mxmxmx/temps_utile-/(threads)

Thread 3 (2016-09-14):

New Arduino IDE (> 1.6.9) breaks TU compile

jeremybernstein, 2016-09-14:
Arduino made a change to the IDE which restricts automatic compilation of resources in subfolders (https://github.com/arduino/arduino-builder/pull/148) which breaks this project (linkage errors). You may need to explicitly #include the cpp files (ugly) or simply move the files to the top-level or a src/ folder.

mxmxmx, 2016-09-14:
brilliant (and thanks for the heads-up).

does this work?
https://github.com/mxmxmx/temps_utile-/tree/fix_6_11

jeremybernstein, 2016-09-14:
Yes it does.

mxmxmx, 2016-09-14:
ok, cool. it doesn't seem to break backwards compatibility either.

Closed 2016-09-14.

Thread 4 (2016-10-08):

Left Encoder button press sync not working

okyeron, 2016-10-08:
I did some poking around in APP_CLK.ino tonight and ran a quick test.

Left-encoder-button press Sync works OK if I make the following modifications:

```
void sync() {
    clk_cnt_ = 0x0;
    div_cnt_ = 0x0;
    ticks_ = 0x0;
  }
```

```
void CLOCKS_leftButton() {

  Clock_channel &selected = clock_channel[clocks_state.selected_channel];

  // sync:
  for (int i = 0; i < NUM_CHANNELS; ++i)
        clock_channel[i].sync();

  if (selected.get_page() == TEMPO) {
    selected.set_page(PARAMETERS);
    clocks_state.cursor = clocks_state.cursor_state;
    selected.update_enabled_settings(clocks_state.selected_channel);
    clocks_state.cursor.AdjustEnd(selected.num_enabled_settings() - 1);
    return;
  }
}

```

Previously it looked like ticks_ was not being reset in the sync() function. I'm not sure that's the right place to reset ticks_ in this case.
And then in CLOCKS_leftButton() it would not sync if you had the TEMPO page loaded. (because returned before sync() was called?)

I need to learn how to use Github properly - hope this works OK for the moment.

okyeron, 2017-01-10:
Code update on Jan 9, 2017 looks to have fixed this.

mxmxmx, 2017-01-10:
yeah, it should have the same effect. zeroing ticks_ in the sync() function would be just as fine, or slightly more straightforward. as for the leftbutton behaviour, i've commented out the menu stuff entirely, so the tempo display doesn't toggle when syncing the channels.

Closed 2017-01-10.

Thread 5 (2016-10-18):

Adding Swing?

okyeron, 2016-10-18:
I had the idea that being able to "swing" the beat for any Temps output would be a really neat feature. The idea being to delay all the even-numbered 16th notes within the beat (2, 4, 6, 8, etc.)

A friend helped me hack together some basic code for this, but we're not sure exactly how to implement it in the codebase so I thought I'd post it here to see if this is something useful.

I tried this around line 838 in the APP_CLK.ino file:
(below the brute force ugly sync hack)

`     // ATTEMPT AT SWING

```
// enc_value = .5;
// this would be a setting for swing amount from encoder input or settings
// some value between 0-1 where 50% is no swing, 66% being triplets

 uint32_t swing_val = 2*channel_frequency_in_ticks_ * enc_value;
 uint32_t frame_length_in_ticks = (clk_cnt_%2 == 0) ? (swing_val) : (2*channel_frequency_in_ticks_- swing_val);

 // time to output ?
 if (subticks_ >= frame_length_in_ticks && _sync) { // ckm: changed 'channel_frequency_in_ticks_' to 'frame_length_in_ticks'
```

`

We made a couple assumptions that clk_cnt_ was "one beat" and that shifting the value for channel_frequency_in_ticks_ would swing the beat output.

mxmxmx, 2017-08-01:
see here now (which adds phase offset, not swing)

https://github.com/mxmxmx/temps_utile-/tree/sync_variation

Closed 2017-08-01.

Thread 7 (2016-11-07):

Multiplys continue to pulse after trig is removed

okyeron, 2016-11-07:
Using both TR inputs. One channel set to "-" another set to 2x. If I remove the trig input on TR2 (pull the cable out of the jack) - that channel (which has a mult "2x") continues to send pulses.

Does not happen with "-" or divs "/x"

Also this seems to happen the other way where it's not sending pulses until you change something - haven't been able to replicate this yet.

mxmxmx, 2016-11-07:
hey,

that's because there's no way knowing the jack has been removed. in theory, some sort of detection mechanism could have been implemented (in parts, in hardware), but i didn't. so when multiplying/running off the internal timer, the module keeps on multiplying; cf 4ms SCM, same thing.

mxmxmx, 2016-11-08:
sure. and sort of, one could do it in software only. ie something like this: if the input trigger frequency increased by this or that amount relative to the previous frequency = someone removed the cable. you'd still get a bunch of triggers at the old frequency. the issue is that in multiplication mode the external clock signals are used to determine the overflow value of an internal timer, they don't actually trigger something; ie it's the last and second-to-last clock that determine the output frequency at any given moment, so when you plug the cable, the timer will sit there.

okyeron, 2016-11-08:
Ah... I see. Great explanation.

Closed 2016-11-07.

Thread 29 (2017-09-15):

Bug that seems to have disappeared... therfore hard to reproduce!

markfrancombe, 2017-09-15:
Hi,
Self built module, immediately after first turn on (therefore suspecting build error) seemed to crash (screen went blank operation stopped in the following situation.
1) audio modules connected to both 1 and 2 outs
2) ch 1 clock source changed to INT for testing Module 1 starts... played with mult/div.. all working as it should
3) went into ch 2 and set clock source to INT, no operation occured... pressed up button, unit crashed.

This situation was completely reproducible every time, every power cycle, UNTIL...
I read the manual and learned about the up button/long press, to get to BPM counter (was wondering about that actually, when I was testing the ch1. ("wheres the f...ing BPM?" I muttered)

However performing this combo, seems to have fixed the issue, tried power cycling even with no setting save and it now does NOT crash and seems to work 100%

Lovely module... fun so far!

mxmxmx, 2019-02-12:
ok, closing this ... (hopefully it didn't reappear!)

Closed 2019-02-12.

Thread 30 (2017-10-05):

Clock source setting do not save

GitBruno, 2017-10-05:
I expected `Clock source` setting to be included in save. (Running 1.2.2 beta)

Is everything saved or are some elements excluded?

Notes:
    I don't see the "saving ....." message, just the growing square
    However clock multiplications did  seem to save correctly
    Switching global trigger on/off does not seem to matter

Banshee700, 2018-01-14:
Yep, i mentioned that as well to Max

Closed 2018-02-23.

Thread 31 (2017-10-13):

clock doesn't start

evancorylevine, 2017-10-13:
I have an issue wherein the clock doesn't start on channel one unless I change the clock source and then change it back again. I am in MULT mode with the PW at 50% and div at /48. I saved this state, but whenever I restart the power the clock source has to be changed and then changed back to TR1 for the clock to begin on this channel. My second channel just starts when I power up. It doesn't need attention.

GitBruno, 2018-09-04:
There must be something wrong with your hardware build. Did you solve this?

mxmxmx, 2019-02-10:
temporary fix here now https://github.com/mxmxmx/temps_utile-/tree/1.3b

Closed 2019-02-10.

Thread 40 (2018-09-23):

external clock different threshold?

thomasvanta, 2018-09-23:
Hi,
I'd like to use my temps with the LZX video system (0-1V range).
This voltage won't trigger the clock input. There's adapters like the lzx bridge or the cadet, but I was wondering if a 'clock-in threshold' would be an easy parameter to implement in the general settings or if its tight to hardware.
:)

mxmxmx, 2018-09-23:
hi,

the threshold (~ 2.8V) is a hardware thing, try removing the two 33k resistors at the TR inputs (ie the voltage dividers before the NPNs)

Closed 2018-09-23.

Thread 47 (2019-03-07):

Inconsistent offset in mult/divide

joodi3k, 2019-03-07:
A channel's behavior is inconsistent when adding offset to divide. I've tested it with no global divide and under 48ppqn. Please see the attached videos as the behavior is so erratic that it defies easy description.

The first video is with no global divide, clock is being provided by a metropolis.
The second is the same but I'm adjusting offset on channel one instead of two.
The third is with 48ppqn being provided by a beat step pro.

https://www.dropbox.com/s/hysvjxpbmwnbui0/IMG_2467.MOV?dl=0

https://www.dropbox.com/s/menuacn9d1vdb5w/IMG_2478.MOV?dl=0

https://www.dropbox.com/s/jzkq2lrqfmxez9w/IMG_2479.MOV?dl=0

In all three cases the metropolis is providing reset every 4 bars.

mxmxmx, 2019-03-07:
so in the absence of easy description, i'm assuming you're saying that:

1. this issue is about the latest firmware version, 1.3beta: https://github.com/mxmxmx/temps_utile-/tree/1.3b

2. i'll be able to reproduce a/the problem simply by doing the following:
    - set divisor to some value > 1
    - set phase parameter to some value > 0

3. the reset stuff has nothing to do with it?

joodi3k, 2019-03-07:
Actually I’m on v1.2.3. I’ll update and see. My understanding of 1.3b was that it does address divider issues, but not the one I’m experiencing.

To your second item, maybe. Some offset values appear to work. Others change the divisor. Some seem to be the incorrect offset. And still others cause the channel to freeze. None of these inconsistencies are terribly “consistent” in that they don’t seem to always come into play at particular offsets. Except at 50%. That seems to always lock up. Even resyncing the TU doesn’t help.

Reset has nothing to do with it in that the reset does not appear to fix any of the errant behavior. Which is to say if reset caused everything to work as intended again, I’d be fine.

While we’re on the subject, I see a couple of other wrong-seeming behaviors in my 1u TU. In LFSR mode, probability doesn’t change the chance of bits flipping unless I have taps established. And even then it’s kind of hard to tell. Haven’t delved into this further because I keep running into the divider issue.

Also, the save and load behavior does not reflect what’s in the manual. I appear to only have one save slot that loads on power up. Which is really all I need, but now that we’re in the weeds it does seem worth noting.

Thanks

Sent from my iPhone

On Mar 6, 2019, at 11:53 PM, mxmxmx <notifications@github.com<mailto:notifications@github.com>> wrote:

so in the absence of easy description, i'm assuming you're saying that:

  1.  this issue is about the latest firmware version, 1.3beta: https://github.com/mxmxmx/temps_utile-/tree/1.3b

  2.  i'll be able to reproduce a/the problem simply by doing the following:

     *   set divisor to some value > 1
     *   set phase parameter to some value > 0
  3.  the reset stuff has nothing to do with it?

—
You are receiving this because you authored the thread.
Reply to this email directly, view it on GitHub<https://github.com/mxmxmx/temps_utile-/issues/47#issuecomment-470395411>, or mute the thread<https://github.com/notifications/unsubscribe-auth/AuEIznCUwKoGYUHwiqSyF5DsmaAlEKInks5vUKlXgaJpZM4biJlj>.

joodi3k, 2019-03-08:
Duh. Latest firmware seems to have cleared up the clock issue, at least with basic testing of the 50% offset. Load/save menu looks correct now. Not sure which version Shay at Plumb loaded mine with when he built it. Or if it just was borked when it got flashed. Thanks for the help.

On Mar 6, 2019, at 11:53 PM, mxmxmx <notifications@github.com<mailto:notifications@github.com>> wrote:

so in the absence of easy description, i'm assuming you're saying that:

  1.  this issue is about the latest firmware version, 1.3beta: https://github.com/mxmxmx/temps_utile-/tree/1.3b

  2.  i'll be able to reproduce a/the problem simply by doing the following:

     *   set divisor to some value > 1
     *   set phase parameter to some value > 0
  3.  the reset stuff has nothing to do with it?

—
You are receiving this because you authored the thread.
Reply to this email directly, view it on GitHub<https://github.com/mxmxmx/temps_utile-/issues/47#issuecomment-470395411>, or mute the thread<https://github.com/notifications/unsubscribe-auth/AuEIznCUwKoGYUHwiqSyF5DsmaAlEKInks5vUKlXgaJpZM4biJlj>.

Jay Reynolds
Tour Manager
Asleep At The Wheel
513-348-7712
jreynolds.bluesky@gmail.com<mailto:jreynolds.bluesky@gmail.com>

mxmxmx, 2019-03-09:
ok, let me know if/when i can close this issue.

re manual: that was updated to reflect v1.3, so you wouldn't have seen the new load/save menu (with 4 slots, not just one)

joodi3k, 2019-03-09:
You can close it. Thanks again.

Sent from my iPhone

On Mar 9, 2019, at 7:28 AM, mxmxmx <notifications@github.com<mailto:notifications@github.com>> wrote:

ok, let me know if/when i can close this issue.

re manual: that was updated to reflect v1.3, so you wouldn't have seen the new load/save menu (with 4 slots, not just one)

—
You are receiving this because you authored the thread.
Reply to this email directly, view it on GitHub<https://github.com/mxmxmx/temps_utile-/issues/47#issuecomment-471176958>, or mute the thread<https://github.com/notifications/unsubscribe-auth/AuEIzmZ2knIC_oKjp0o4TsChyddRKe18ks5vU7bfgaJpZM4biJlj>.

mxmxmx, 2019-03-10:
perfect, thanks!

Closed 2019-03-10.

Thread 51 (2020-01-04):

Pulsewidth and Global division setting no longer saved in v1.3

7dials, 2020-01-04:
Hi, I recently tried updating to firmware version 1.3 but have had to revert to version 1.2.3 as I find the new version unusable due to the following issues.

- The pulsewidth set in each channel is no longer saved.
- The global division setting for input TR1 is no longer saved.

This meant I had to reapply these setting every time I turned my modular back on and while the idea of user slots is attractive these issues make the unit unusable in a live situation.

patrickdowling, 2020-04-25:
FWIW this came up in the thread on MW last week, I've put tentative fixes here: [fix/misc_fix](https://github.com/patrickdowling/temps_utile-/tree/fix/misc_fix)

It only later occurred to me to check the issues here.
That's based off master, I'm not really current on which branch might be more up to date.

SimonKunz, 2020-11-19:
@patrickdowling Thank you for publishing your fixes. Just one question: will your fixed version of the firmware keep my calibration settings on the t_u when I install it like described [here](https://github.com/mxmxmx/temps_utile-/wiki/firmware#compile-the-firmware-yourself)?

Thank you!

patrickdowling, 2020-11-19:
Yes, calibration should remain intact.
The preset slots will be lost though -- the versioning isn't particularly smart.

SimonKunz, 2020-11-19:
I don't even use the preset slots to be honest. Thank you :-)

Thread 54 (2022-07-24):

TR#1/#2 as LOGIC inputs

ph1-xyz, 2022-07-24:
I expected to be able to perform the `LOGIC` function on `TR1` and `TR2`, but only `CH#1`, `CH#2`, ..., `CH#6`_ were available. Is this an hardware limitation?

At the other end, it would have been great to be able to select Channels Outputs as inputs for other apps, which currently allow only `INT`, `TR1`, `TR2`. Would this be possible?

Thanks for Temps! It is great!!

patrickdowling, 2022-07-26:
It’s not a hardware limitation, but maybe a conceptual one because of the way things are “routed” to generate a clock which drives the channel function. All the channel operations like logic then don’t use `TRx` directly (at least that’s how I remember it). It’s “just software” so anything’s possible but it’d be a bunch of/more special casing.

Similarly using other channels’ outputs is maybe a bit awkward to implement but should work in theory, although there might be some caveats in practice.

Thread 55 (2022-07-30):

Changing voltage levels of clock outputs

denniskulpa, 2022-07-30:
Reading a comment in the BOM regarding the clock output levels:

"the (digital) clock outputs are **non-inverting op amps**, the values on the pcb (20k feedback, 10k to ground) will result in 3x gain, or 9.9v on the outputs. adjust, if you like. for example, 15k would give you 3.3v * (20k/15k + 1) = 7.7, etc."

I'm thinking about doing this (lowering them, closer to 5-6V).  Since there isn't a firm schematic, I've traced the paths on the PCB, verified with a multi-meter,  it looks like I'd have to change the resistors highlighted in RED on this layout:

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

I would leave the DAC output as-is, just alter the outs for the other five channels (1, 2, 3, 5, & 6).  Are these the correct components to change?  If not, what are the correct resistors?

TIA,
Dennis Kulpa

denniskulpa, 2022-08-08:
Just following up, those are the correct resistors to change.  I used 20K resistors in place of the 10K called for in the BOM, I'm getting 6.8V triggers out of the 5 channels.  Only been running it for about 2 hours but, so far, I have not had any problems triggering modules in my rack; we'll see what happens.

Closed 2022-08-08.

Thread 56 (2023-04-23):

Errors Compiling with Arduino 1.8.19 and Teensyduino 1.58

djpeterso23662, 2023-04-23:
Good afternoon!  I am trying to run Arduino Verify on temps_utile- on a fresh install of Arduino 1.8.19 and Teensyduino 1.58 on Windows 10.  I am receiving the errors below.  I have the board, CPU Speed, and Optimize settings set for TU as instructed.  Do you have any suggestions, please, how I can proceed?  I apologize for sharing the long compiler input-- Teensy is not a platform I am familiar with.  Thanks so much!

```
Arduino: 1.8.19 (Windows 10), TD: 1.58, Board: "Teensy 3.2 / 3.1, Serial, 120 MHz (overclock), Faster, US English"

C:\arduino-1.8.19\arduino-builder -dump-prefs -logger=machine -hardware C:\arduino-1.8.19\hardware -tools C:\arduino-1.8.19\tools-builder -tools C:\arduino-1.8.19\hardware\tools\avr -built-in-libraries C:\arduino-1.8.19\libraries -libraries C:\Users\rfuser37\Documents\Arduino\libraries -fqbn=teensy:avr:teensy31:usb=serial,speed=120,opt=o2std,keys=en-us -ide-version=10819 -build-path C:\Users\rfuser37\AppData\Local\Temp\8\arduino_build_868009 -warnings=none -build-cache C:\Users\rfuser37\AppData\Local\Temp\8\arduino_cache_904313 -verbose C:\msys64\home\rfuser37\temps_utile-\soft\t_u_REV\t_u_REV.ino

C:\arduino-1.8.19\arduino-builder -compile -logger=machine -hardware C:\arduino-1.8.19\hardware -tools C:\arduino-1.8.19\tools-builder -tools C:\arduino-1.8.19\hardware\tools\avr -built-in-libraries C:\arduino-1.8.19\libraries -libraries C:\Users\rfuser37\Documents\Arduino\libraries -fqbn=teensy:avr:teensy31:usb=serial,speed=120,opt=o2std,keys=en-us -ide-version=10819 -build-path C:\Users\rfuser37\AppData\Local\Temp\8\arduino_build_868009 -warnings=none -build-cache C:\Users\rfuser37\AppData\Local\Temp\8\arduino_cache_904313 -verbose C:\msys64\home\rfuser37\temps_utile-\soft\t_u_REV\t_u_REV.ino

Using board 'teensy31' from platform in folder: C:\arduino-1.8.19\hardware\teensy\avr

Using core 'teensy3' from platform in folder: C:\arduino-1.8.19\hardware\teensy\avr

Detecting libraries used...

"C:\\arduino-1.8.19\\hardware\\teensy/../tools/arm/bin/arm-none-eabi-g++" -E -CC -x c++ -w -g -Wall -ffunction-sections -fdata-sections -nostdlib -mno-unaligned-access -fno-exceptions -fpermissive -felide-constructors -std=gnu++14 -Wno-error=narrowing -fno-rtti -mthumb -mcpu=cortex-m4 -fsingle-precision-constant -D__MK20DX256__ -DTEENSYDUINO=158 -DARDUINO=10819 -DARDUINO_TEENSY32 -DF_CPU=120000000 -DUSB_SERIAL -DLAYOUT_US_ENGLISH "-IC:\\arduino-1.8.19\\hardware\\teensy\\avr\\cores\\teensy3" "C:\\Users\\rfuser37\\AppData\\Local\\Temp\\8\\arduino_build_868009\\sketch\\t_u_REV.ino.cpp" -o nul

Alternatives for EEPROM.h: [EEPROM@2.0]

ResolveLibrary(EEPROM.h)

  -> candidates: [EEPROM@2.0]

"C:\\arduino-1.8.19\\hardware\\teensy/../tools/arm/bin/arm-none-eabi-g++" -E -CC -x c++ -w -g -Wall -ffunction-sections -fdata-sections -nostdlib -mno-unaligned-access -fno-exceptions -fpermissive -felide-constructors -std=gnu++14 -Wno-error=narrowing -fno-rtti -mthumb -mcpu=cortex-m4 -fsingle-precision-constant -D__MK20DX256__ -DTEENSYDUINO=158 -DARDUINO=10819 -DARDUINO_TEENSY32 -DF_CPU=120000000 -DUSB_SERIAL -DLAYOUT_US_ENGLISH "-IC:\\arduino-1.8.19\\hardware\\teensy\\avr\\cores\\teensy3" "-IC:\\arduino-1.8.19\\hardware\\teensy\\avr\\libraries\\EEPROM" "C:\\Users\\rfuser37\\AppData\\Local\\Temp\\8\\arduino_build_868009\\sketch\\t_u_REV.ino.cpp" -o nul

Using cached library dependencies for file: C:\Users\rfuser37\AppData\Local\Temp\8\arduino_build_868009\sketch\TU_ADC.cpp

Using cached library dependencies for file: C:\Users\rfuser37\AppData\Local\Temp\8\arduino_build_868009\sketch\TU_app_menu.cpp

Using cached library dependencies for file: C:\Users\rfuser37\AppData\Local\Temp\8\arduino_build_868009\sketch\TU_app_storage.cpp

Using cached library dependencies for file: C:\Users\rfuser37\AppData\Local\Temp\8\arduino_build_868009\sketch\TU_apps.cpp

Using cached library dependencies for file: C:\Users\rfuser37\AppData\Local\Temp\8\arduino_build_868009\sketch\TU_bitmaps.cpp

Using cached library dependencies for file: C:\Users\rfuser37\AppData\Local\Temp\8\arduino_build_868009\sketch\TU_debug.cpp

Using cached library dependencies for file: C:\Users\rfuser37\AppData\Local\Temp\8\arduino_build_868009\sketch\TU_digital_inputs.cpp

Using cached library dependencies for file: C:\Users\rfuser37\AppData\Local\Temp\8\arduino_build_868009\sketch\TU_global_config.cpp

Using cached library dependencies for file: C:\Users\rfuser37\AppData\Local\Temp\8\arduino_build_868009\sketch\TU_input_map.cpp

Using cached library dependencies for file: C:\Users\rfuser37\AppData\Local\Temp\8\arduino_build_868009\sketch\TU_menus.cpp

Using cached library dependencies for file: C:\Users\rfuser37\AppData\Local\Temp\8\arduino_build_868009\sketch\TU_outputs.cpp

Using cached library dependencies for file: C:\Users\rfuser37\AppData\Local\Temp\8\arduino_build_868009\sketch\TU_patterns.cpp

Using cached library dependencies for file: C:\Users\rfuser37\AppData\Local\Temp\8\arduino_build_868009\sketch\TU_strings.cpp

Using cached library dependencies for file: C:\Users\rfuser37\AppData\Local\Temp\8\arduino_build_868009\sketch\TU_ui.cpp

Using cached library dependencies for file: C:\Users\rfuser37\AppData\Local\Temp\8\arduino_build_868009\sketch\peaks_resources.cpp

Using cached library dependencies for file: C:\Users\rfuser37\AppData\Local\Temp\8\arduino_build_868009\sketch\streams_lorenz_generator.cpp

Using cached library dependencies for file: C:\Users\rfuser37\AppData\Local\Temp\8\arduino_build_868009\sketch\streams_resources.cpp

Using cached library dependencies for file: C:\Users\rfuser37\AppData\Local\Temp\8\arduino_build_868009\sketch\src\ADC\ADC_Module.cpp

Using cached library dependencies for file: C:\Users\rfuser37\AppData\Local\Temp\8\arduino_build_868009\sketch\src\ADC\OC_util_ADC.cpp

Using cached library dependencies for file: C:\Users\rfuser37\AppData\Local\Temp\8\arduino_build_868009\sketch\src\ADC\RingBuffer.cpp

Using cached library dependencies for file: C:\Users\rfuser37\AppData\Local\Temp\8\arduino_build_868009\sketch\src\ADC\RingBufferDMA.cpp

Using cached library dependencies for file: C:\Users\rfuser37\AppData\Local\Temp\8\arduino_build_868009\sketch\src\SH1106_128x64_driver.cpp

Using cached library dependencies for file: C:\Users\rfuser37\AppData\Local\Temp\8\arduino_build_868009\sketch\src\display.cpp

Using cached library dependencies for file: C:\Users\rfuser37\AppData\Local\Temp\8\arduino_build_868009\sketch\src\util_misc.cpp

Using cached library dependencies for file: C:\Users\rfuser37\AppData\Local\Temp\8\arduino_build_868009\sketch\src\weegfx.cpp

Using cached library dependencies for file: C:\arduino-1.8.19\hardware\teensy\avr\libraries\EEPROM\EEPROM.cpp

Generating function prototypes...

"C:\\arduino-1.8.19\\hardware\\teensy/../tools/arm/bin/arm-none-eabi-g++" -E -CC -x c++ -w -g -Wall -ffunction-sections -fdata-sections -nostdlib -mno-unaligned-access -fno-exceptions -fpermissive -felide-constructors -std=gnu++14 -Wno-error=narrowing -fno-rtti -mthumb -mcpu=cortex-m4 -fsingle-precision-constant -D__MK20DX256__ -DTEENSYDUINO=158 -DARDUINO=10819 -DARDUINO_TEENSY32 -DF_CPU=120000000 -DUSB_SERIAL -DLAYOUT_US_ENGLISH "-IC:\\arduino-1.8.19\\hardware\\teensy\\avr\\cores\\teensy3" "-IC:\\arduino-1.8.19\\hardware\\teensy\\avr\\libraries\\EEPROM" "C:\\Users\\rfuser37\\AppData\\Local\\Temp\\8\\arduino_build_868009\\sketch\\t_u_REV.ino.cpp" -o "C:\\Users\\rfuser37\\AppData\\Local\\Temp\\8\\arduino_build_868009\\preproc\\ctags_target_for_gcc_minus_e.cpp"

"C:\\arduino-1.8.19\\tools-builder\\ctags\\5.8-arduino11/ctags" -u --language-force=c++ -f - --c++-kinds=svpf --fields=KSTtzns --line-directives "C:\\Users\\rfuser37\\AppData\\Local\\Temp\\8\\arduino_build_868009\\preproc\\ctags_target_for_gcc_minus_e.cpp"

Compiling sketch...

"C:\\arduino-1.8.19\\hardware\\teensy/../tools/precompile_helper" "C:\\arduino-1.8.19\\hardware\\teensy\\avr/cores/teensy3" "C:\\Users\\rfuser37\\AppData\\Local\\Temp\\8\\arduino_build_868009" "C:\\arduino-1.8.19\\hardware\\teensy/../tools/arm/bin/arm-none-eabi-g++" -x c++-header -O2 -g -Wall -ffunction-sections -fdata-sections -nostdlib -mno-unaligned-access -MMD -fno-exceptions -fpermissive -felide-constructors -std=gnu++14 -Wno-error=narrowing -fno-rtti -mthumb -mcpu=cortex-m4 -fsingle-precision-constant -D__MK20DX256__ -DTEENSYDUINO=158 -DARDUINO=10819 -DARDUINO_TEENSY32 -DF_CPU=120000000 -DUSB_SERIAL -DLAYOUT_US_ENGLISH "-IC:\\arduino-1.8.19\\hardware\\teensy\\avr/cores/teensy3" "C:\\Users\\rfuser37\\AppData\\Local\\Temp\\8\\arduino_build_868009/pch/Arduino.h" -o "C:\\Users\\rfuser37\\AppData\\Local\\Temp\\8\\arduino_build_868009/pch/Arduino.h.gch"

Using previously compiled file: C:\Users\rfuser37\AppData\Local\Temp\8\arduino_build_868009\pch\Arduino.h.gch

Using previously compiled file: C:\Users\rfuser37\AppData\Local\Temp\8\arduino_build_868009\sketch\TU_bitmaps.cpp.o

Using previously compiled file: C:\Users\rfuser37\AppData\Local\Temp\8\arduino_build_868009\sketch\TU_outputs.cpp.o

Using previously compiled file: C:\Users\rfuser37\AppData\Local\Temp\8\arduino_build_868009\sketch\TU_strings.cpp.o

Using previously compiled file: C:\Users\rfuser37\AppData\Local\Temp\8\arduino_build_868009\sketch\TU_global_config.cpp.o

Using previously compiled file: C:\Users\rfuser37\AppData\Local\Temp\8\arduino_build_868009\sketch\TU_digital_inputs.cpp.o

Using previously compiled file: C:\Users\rfuser37\AppData\Local\Temp\8\arduino_build_868009\sketch\TU_menus.cpp.o

Using previously compiled file: C:\Users\rfuser37\AppData\Local\Temp\8\arduino_build_868009\sketch\TU_ADC.cpp.o

"C:\\arduino-1.8.19\\hardware\\teensy/../tools/arm/bin/arm-none-eabi-g++" -c -O2 -g -Wall -ffunction-sections -fdata-sections -nostdlib -mno-unaligned-access -MMD -fno-exceptions -fpermissive -felide-constructors -std=gnu++14 -Wno-error=narrowing -fno-rtti -mthumb -mcpu=cortex-m4 -fsingle-precision-constant -D__MK20DX256__ -DTEENSYDUINO=158 -DARDUINO=10819 -DARDUINO_TEENSY32 -DF_CPU=120000000 -DUSB_SERIAL -DLAYOUT_US_ENGLISH "-IC:\\Users\\rfuser37\\AppData\\Local\\Temp\\8\\arduino_build_868009/pch" "-IC:\\arduino-1.8.19\\hardware\\teensy\\avr\\cores\\teensy3" "-IC:\\arduino-1.8.19\\hardware\\teensy\\avr\\libraries\\EEPROM" "C:\\Users\\rfuser37\\AppData\\Local\\Temp\\8\\arduino_build_868009\\sketch\\t_u_REV.ino.cpp" -o "C:\\Users\\rfuser37\\AppData\\Local\\Temp\\8\\arduino_build_868009\\sketch\\t_u_REV.ino.cpp.o"

Using previously compiled file: C:\Users\rfuser37\AppData\Local\Temp\8\arduino_build_868009\sketch\TU_debug.cpp.o

Using previously compiled file: C:\Users\rfuser37\AppData\Local\Temp\8\arduino_build_868009\sketch\streams_lorenz_generator.cpp.o

Using previously compiled file: C:\Users\rfuser37\AppData\Local\Temp\8\arduino_build_868009\sketch\streams_resources.cpp.o

Using previously compiled file: C:\Users\rfuser37\AppData\Local\Temp\8\arduino_build_868009\sketch\TU_app_menu.cpp.o

Using previously compiled file: C:\Users\rfuser37\AppData\Local\Temp\8\arduino_build_868009\sketch\TU_apps.cpp.o

Using previously compiled file: C:\Users\rfuser37\AppData\Local\Temp\8\arduino_build_868009\sketch\TU_patterns.cpp.o

Using previously compiled file: C:\Users\rfuser37\AppData\Local\Temp\8\arduino_build_868009\sketch\peaks_resources.cpp.o

Using previously compiled file: C:\Users\rfuser37\AppData\Local\Temp\8\arduino_build_868009\sketch\TU_input_map.cpp.o

Using previously compiled file: C:\Users\rfuser37\AppData\Local\Temp\8\arduino_build_868009\sketch\TU_app_storage.cpp.o

Using previously compiled file: C:\Users\rfuser37\AppData\Local\Temp\8\arduino_build_868009\sketch\TU_ui.cpp.o

In file included from C:\msys64\home\rfuser37\temps_utile-\soft\t_u_REV\APP_CLK.ino:29:

C:\msys64\home\rfuser37\temps_utile-\soft\t_u_REV\TU_pattern_edit.h: In member function 'void TU::PatternEditor<Owner>::handleButtonUp(const UI::Event&)':

TU_pattern_edit.h:407: warning: '~' on an expression of type 'bool'

  407 |       fine_coarse_ = (~fine_coarse_) & 1u;

      |                        ^~~~~~~~~~~~

C:\msys64\home\rfuser37\temps_utile-\soft\t_u_REV\TU_pattern_edit.h:407:24: note: did you mean to use logical not ('!')?

C:\msys64\home\rfuser37\temps_utile-\soft\t_u_REV\TU_pattern_edit.h: In instantiation of 'void TU::PatternEditor<Owner>::handleButtonUp(const UI::Event&) [with Owner = Clock_channel]':

C:\msys64\home\rfuser37\temps_utile-\soft\t_u_REV\TU_pattern_edit.h:293:9:   required from 'void TU::PatternEditor<Owner>::HandleButtonEvent(const UI::Event&) [with Owner = Clock_channel]'

C:\msys64\home\rfuser37\temps_utile-\soft\t_u_REV\APP_CLK.ino:2703:50:   required from here

TU_pattern_edit.h:407: warning: '~' on an expression of type 'bool'

C:\msys64\home\rfuser37\temps_utile-\soft\t_u_REV\TU_pattern_edit.h:407:24: note: did you mean to use logical not ('!')?

Using previously compiled file: C:\Users\rfuser37\AppData\Local\Temp\8\arduino_build_868009\sketch\src\SH1106_128x64_driver.cpp.o

Using previously compiled file: C:\Users\rfuser37\AppData\Local\Temp\8\arduino_build_868009\sketch\src\util_misc.cpp.o

Using previously compiled file: C:\Users\rfuser37\AppData\Local\Temp\8\arduino_build_868009\sketch\src\display.cpp.o

Using previously compiled file: C:\Users\rfuser37\AppData\Local\Temp\8\arduino_build_868009\sketch\src\ADC\RingBuffer.cpp.o

Using previously compiled file: C:\Users\rfuser37\AppData\Local\Temp\8\arduino_build_868009\sketch\src\weegfx.cpp.o

Using previously compiled file: C:\Users\rfuser37\AppData\Local\Temp\8\arduino_build_868009\sketch\src\ADC\ADC_Module.cpp.o

Using previously compiled file: C:\Users\rfuser37\AppData\Local\Temp\8\arduino_build_868009\sketch\src\ADC\OC_util_ADC.cpp.o

Using previously compiled file: C:\Users\rfuser37\AppData\Local\Temp\8\arduino_build_868009\sketch\src\ADC\RingBufferDMA.cpp.o

Compiling libraries...

Compiling library "EEPROM"

Using previously compiled file: C:\Users\rfuser37\AppData\Local\Temp\8\arduino_build_868009\libraries\EEPROM\EEPROM.cpp.o

Compiling core...

Using precompiled core: C:\Users\rfuser37\AppData\Local\Temp\8\arduino_cache_904313\core\core_8383bc6b34a5e230b55ed140c641d6cf.a

Linking everything together...

"C:\\arduino-1.8.19\\hardware\\teensy/../tools/arm/bin/arm-none-eabi-gcc" -O2 -Wl,--gc-sections,--relax,--defsym=__rtc_localtime=1682255371 "-TC:\\arduino-1.8.19\\hardware\\teensy\\avr\\cores\\teensy3/mk20dx256.ld" -mthumb -mcpu=cortex-m4 -fsingle-precision-constant -o "C:\\Users\\rfuser37\\AppData\\Local\\Temp\\8\\arduino_build_868009/t_u_REV.ino.elf" "C:\\Users\\rfuser37\\AppData\\Local\\Temp\\8\\arduino_build_868009\\sketch\\TU_ADC.cpp.o" "C:\\Users\\rfuser37\\AppData\\Local\\Temp\\8\\arduino_build_868009\\sketch\\TU_app_menu.cpp.o" "C:\\Users\\rfuser37\\AppData\\Local\\Temp\\8\\arduino_build_868009\\sketch\\TU_app_storage.cpp.o" "C:\\Users\\rfuser37\\AppData\\Local\\Temp\\8\\arduino_build_868009\\sketch\\TU_apps.cpp.o" "C:\\Users\\rfuser37\\AppData\\Local\\Temp\\8\\arduino_build_868009\\sketch\\TU_bitmaps.cpp.o" "C:\\Users\\rfuser37\\AppData\\Local\\Temp\\8\\arduino_build_868009\\sketch\\TU_debug.cpp.o" "C:\\Users\\rfuser37\\AppData\\Local\\Temp\\8\\arduino_build_868009\\sketch\\TU_digital_inputs.cpp.o" "C:\\Users\\rfuser37\\AppData\\Local\\Temp\\8\\arduino_build_868009\\sketch\\TU_global_config.cpp.o" "C:\\Users\\rfuser37\\AppData\\Local\\Temp\\8\\arduino_build_868009\\sketch\\TU_input_map.cpp.o" "C:\\Users\\rfuser37\\AppData\\Local\\Temp\\8\\arduino_build_868009\\sketch\\TU_menus.cpp.o" "C:\\Users\\rfuser37\\AppData\\Local\\Temp\\8\\arduino_build_868009\\sketch\\TU_outputs.cpp.o" "C:\\Users\\rfuser37\\AppData\\Local\\Temp\\8\\arduino_build_868009\\sketch\\TU_patterns.cpp.o" "C:\\Users\\rfuser37\\AppData\\Local\\Temp\\8\\arduino_build_868009\\sketch\\TU_strings.cpp.o" "C:\\Users\\rfuser37\\AppData\\Local\\Temp\\8\\arduino_build_868009\\sketch\\TU_ui.cpp.o" "C:\\Users\\rfuser37\\AppData\\Local\\Temp\\8\\arduino_build_868009\\sketch\\peaks_resources.cpp.o" "C:\\Users\\rfuser37\\AppData\\Local\\Temp\\8\\arduino_build_868009\\sketch\\streams_lorenz_generator.cpp.o" "C:\\Users\\rfuser37\\AppData\\Local\\Temp\\8\\arduino_build_868009\\sketch\\streams_resources.cpp.o" "C:\\Users\\rfuser37\\AppData\\Local\\Temp\\8\\arduino_build_868009\\sketch\\t_u_REV.ino.cpp.o" "C:\\Users\\rfuser37\\AppData\\Local\\Temp\\8\\arduino_build_868009\\sketch\\src\\ADC\\ADC_Module.cpp.o" "C:\\Users\\rfuser37\\AppData\\Local\\Temp\\8\\arduino_build_868009\\sketch\\src\\ADC\\OC_util_ADC.cpp.o" "C:\\Users\\rfuser37\\AppData\\Local\\Temp\\8\\arduino_build_868009\\sketch\\src\\ADC\\RingBuffer.cpp.o" "C:\\Users\\rfuser37\\AppData\\Local\\Temp\\8\\arduino_build_868009\\sketch\\src\\ADC\\RingBufferDMA.cpp.o" "C:\\Users\\rfuser37\\AppData\\Local\\Temp\\8\\arduino_build_868009\\sketch\\src\\SH1106_128x64_driver.cpp.o" "C:\\Users\\rfuser37\\AppData\\Local\\Temp\\8\\arduino_build_868009\\sketch\\src\\display.cpp.o" "C:\\Users\\rfuser37\\AppData\\Local\\Temp\\8\\arduino_build_868009\\sketch\\src\\util_misc.cpp.o" "C:\\Users\\rfuser37\\AppData\\Local\\Temp\\8\\arduino_build_868009\\sketch\\src\\weegfx.cpp.o" "C:\\Users\\rfuser37\\AppData\\Local\\Temp\\8\\arduino_build_868009\\libraries\\EEPROM\\EEPROM.cpp.o" "C:\\Users\\rfuser37\\AppData\\Local\\Temp\\8\\arduino_build_868009/..\\arduino_cache_904313\\core\\core_8383bc6b34a5e230b55ed140c641d6cf.a" "-LC:\\Users\\rfuser37\\AppData\\Local\\Temp\\8\\arduino_build_868009" -larm_cortexM4l_math -lm -lstdc++

c:/arduino-1.8.19/hardware/tools/arm/bin/../lib/gcc/arm-none-eabi/11.3.1/../../../../arm-none-eabi/bin/ld.exe: c:/arduino-1.8.19/hardware/tools/arm/bin/../lib/gcc/arm-none-eabi/11.3.1/thumb/v7e-m/nofp\libc.a(libc_a-writer.o): in function `_write_r':

(.text._write_r+0x14): undefined reference to `_write'

collect2.exe: error: ld returned 1 exit status

Using library EEPROM at version 2.0 in folder: C:\arduino-1.8.19\hardware\teensy\avr\libraries\EEPROM

Error compiling for board Teensy 3.2 / 3.1.
```

djpeterso23662, 2023-04-27:
Okay, I received errors compiling with teensyduino 1.58, and with 1.57.  But no errors and a successful compile with teensyduino 1.56.  Successfully loaded firmware.  This is with Arduino 1.8.19.

Closed 2023-04-27.

Thread 57 (2023-06-23):

Can't compile

RobAnt, 2023-06-23:
Hello-

I just built this from a kit from synthCube and am stuck at the firmware portion.

I already had the Arduino IDE as I've used it in the past.  added the Teensy board, and grabbed the code.

When running a verify I get the following error:

```In file included from C:\Users\roban\Documents\Arduino\temps_utile--master\soft\t_u_REV\APP_CLK.ino:29:
C:\Users\roban\Documents\Arduino\temps_utile--master\soft\t_u_REV\TU_pattern_edit.h: In member function 'void TU::PatternEditor<Owner>::handleButtonUp(const UI::Event&)':
C:\Users\roban\Documents\Arduino\temps_utile--master\soft\t_u_REV\TU_pattern_edit.h:407:24: warning: '~' on an expression of type 'bool' [-Wbool-operation]
  407 |       fine_coarse_ = (~fine_coarse_) & 1u;
      |                        ^~~~~~~~~~~~
C:\Users\roban\Documents\Arduino\temps_utile--master\soft\t_u_REV\TU_pattern_edit.h:407:24: note: did you mean to use logical not ('!')?
C:\Users\roban\Documents\Arduino\temps_utile--master\soft\t_u_REV\TU_pattern_edit.h: In instantiation of 'void TU::PatternEditor<Owner>::handleButtonUp(const UI::Event&) [with Owner = Clock_channel]':
C:\Users\roban\Documents\Arduino\temps_utile--master\soft\t_u_REV\TU_pattern_edit.h:293:9:   required from 'void TU::PatternEditor<Owner>::HandleButtonEvent(const UI::Event&) [with Owner = Clock_channel]'
C:\Users\roban\Documents\Arduino\temps_utile--master\soft\t_u_REV\APP_CLK.ino:2703:50:   required from here
C:\Users\roban\Documents\Arduino\temps_utile--master\soft\t_u_REV\TU_pattern_edit.h:407:24: warning: '~' on an expression of type 'bool' [-Wbool-operation]
C:\Users\roban\Documents\Arduino\temps_utile--master\soft\t_u_REV\TU_pattern_edit.h:407:24: note: did you mean to use logical not ('!')?
c:/users/roban/appdata/local/arduino15/packages/teensy/tools/teensy-compile/11.3.1/arm/bin/../lib/gcc/arm-none-eabi/11.3.1/../../../../arm-none-eabi/bin/ld.exe: c:/users/roban/appdata/local/arduino15/packages/teensy/tools/teensy-compile/11.3.1/arm/bin/../lib/gcc/arm-none-eabi/11.3.1/thumb/v7e-m/nofp\libc.a(libc_a-writer.o): in function `_write_r':
(.text._write_r+0x14): undefined reference to `_write'
collect2.exe: error: ld returned 1 exit status

exit status 1

Compilation error: exit status 1
```

I know the tilde is a bitwise NOT and fine_course_ is declared as a bool.  Should I just change the ~ to a ! and hope it works?  Didn't want to mess things up hence asking the question...

Thanks!

patrickdowling, 2023-06-24:
The warning is annoying but not critical., the error
```
...undefined reference to `_write'
```
is from the linker so that's the Teensy/Arduino "stuff". Not sure if there's an easy workaround (maybe turning off lto?) so you might need to use an older version. I gave up on the IDE long ago for platformio -- see [this branch](https://github.com/patrickdowling/temps_utile-/tree/dev/build) -- but really there isn't any on-going maintenance there either :)

booleanvalue, 2024-03-03:
This helps [https://forum.pjrc.com/index.php?threads/undefined-reference-to-_write.71420/](https://forum.pjrc.com/index.php?threads/undefined-reference-to-_write.71420/)

Do note that it still won't compile for 3.2 if the program has no usage of any Print class members without similar:
`void setup() {
  Serial.begin(9600);
  //Serial.println("setup begin"); // won't compile on Teensy 3.x without this line
  printf("Hello World\n");
}`

chailight, 2024-10-08:
I was able to get it to compile using VS Code with the PlatformIO extension.
I had to add the following line to the platformio.ini file

build_flags = -D USB_MIDI -llibc -lc

I'm not 100% sure about the USB_MIDI flag, but that is what is suggested in the following post:
https://forum.pjrc.com/index.php?threads/tutorial-how-to-use-platformio-visual-code-studio-for-teensy.66674/

The suggestion for -llibc -lc comes from here:
https://stackoverflow.com/questions/55784235/platformio-linker-error-when-including-functional

jmsiener, 2024-10-08:
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

Have tried marking the explicit versions of Arduino and teensyduino in your platform.ini file? This is going to use a much older Arduino/Teensyduino version but I also can’t tell you what version of either was used to write this code.
