mxmxmx/temps_utile-/soft/t_u_REV/TU_menus.h

// Copyright (c) 2016 Patrick Dowling
//
// Author: Patrick Dowling (pld@gurkenkiste.com)
//
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
// Menu drawing helpers

#ifndef TU_MENUS_H
#define TU_MENUS_H

#include "src/weegfx.h"
#include "src/util_misc.h"
#include "TU_bitmaps.h"
#include "util/util_macros.h"
#include "util/util_settings.h"

namespace TU {

void visualize_pitch_classes(uint8_t *normalized, weegfx::coord_t centerx, weegfx::coord_t centery);

void screensaver();
void scope_render();
void vectorscope_render();

namespace menu {

void Init();

static constexpr weegfx::coord_t kDisplayWidth = weegfx::Graphics::kWidth;
static constexpr weegfx::coord_t kDisplayHeight = weegfx::Graphics::kHeight;
static constexpr weegfx::coord_t kMenuLineH = 12;
static constexpr weegfx::coord_t kFontHeight = 8;
static constexpr weegfx::coord_t kDefaultMenuStartX = 0;
static constexpr weegfx::coord_t kDefaultValueX = 96;
static constexpr weegfx::coord_t kDefaultMenuEndX = kDisplayWidth - 2;
static constexpr weegfx::coord_t kIndentDx = 2;
static constexpr weegfx::coord_t kTextDy = 2;

static constexpr int kScreenLines = 4;

static inline weegfx::coord_t CalcLineY(int line) {
  return (line + 1) * kMenuLineH + 2 + 1;
}

// Helper to manage cursor position in settings-type menus.
// The "fancy" mode tries to indicate that there may be more items by not
// moving to line 0 until the first item is selected (and vice versa for end
// of list).
// Currently assumes there are at least 4 items!
template <int screen_lines, bool fancy = true>
class ScreenCursor {
public:
  ScreenCursor() { }
  ~ScreenCursor() { }

  void Init(int start, int end) {
    editing_ = false;
    start_ = start;
    end_ = end;
    cursor_pos_ = start;
    screen_line_ = 0;
  }

  void reInit(int start, int end) {
    start_ = start;
    end_ = end;
    cursor_pos_ = start;
    screen_line_ = 0;
  }

  void AdjustEnd(int end) {
    // WARN This has a specific use case where we don't have to adjust screen line!
    end_ = end;
  }

  void Scroll(int amount) {
    int pos = cursor_pos_ + amount;
    CONSTRAIN(pos, start_, end_);
    cursor_pos_ = pos;

    int screen_line = screen_line_ + amount;
    if (fancy && (end_ - start_ >= screen_lines)) {
      if (amount < 0) {
        if (screen_line < 2) {
          if (pos >= start_ + 1)
            screen_line = 1;
          else
            screen_line = 0;
        }
      } else {
        if (screen_line >= screen_lines - 2) {
          if (pos <= end_ - 1)
            screen_line = screen_lines - 2;
          else
            screen_line = screen_lines - 1;
        }
      }
    } else {
      if (end_ - start_ < screen_lines)
        CONSTRAIN(screen_line, 0, (end_ - start_));
      else
        CONSTRAIN(screen_line, 0, screen_lines - 1);
    }
    screen_line_ = screen_line;
  }

  inline int cursor_pos() const {
    return cursor_pos_;
  }

  inline int first_visible() const {
    return cursor_pos_ - screen_line_;
  }

  inline int last_visible() const {
    if (end_ - start_ < 4)
      return end_ - start_;
    else
      return cursor_pos_ - screen_line_ + screen_lines - 1;
  }

  inline bool editing() const {
    return editing_;
  }

  inline void toggle_editing() {
    editing_ = !editing_;
  }

  inline void set_editing(bool enable) {
    editing_ = enable;
  }

private:
  bool editing_;

  int start_, end_;
  int cursor_pos_;
  int screen_line_;
};

inline void DrawEditIcon(weegfx::coord_t x, weegfx::coord_t y, int value, int min_value, int max_value) {
  const uint8_t *src = TU::bitmap_edit_indicators_8;
  if (value == max_value)
    src += TU::kBitmapEditIndicatorW * 2;
  else if (value == min_value)
    src += TU::kBitmapEditIndicatorW;

  graphics.drawBitmap8(x - 5, y + 1, TU::kBitmapEditIndicatorW, src);
}

inline void DrawEditIcon(weegfx::coord_t x, weegfx::coord_t y, int value, const settings::value_attr &attr) {
  const uint8_t *src = TU::bitmap_edit_indicators_8;
  if (value == attr.max_)
    src += TU::kBitmapEditIndicatorW * 2;
  else if (value == attr.min_)
    src += TU::kBitmapEditIndicatorW;

  graphics.drawBitmap8(x - 5, y + 1, TU::kBitmapEditIndicatorW, src);
}

template <bool rtl, size_t max_bits, weegfx::coord_t height, weegfx::coord_t padding>
void DrawMask(weegfx::coord_t x, weegfx::coord_t y, uint32_t mask, size_t count, uint8_t clock_indicator) {
  weegfx::coord_t dx;
  if (count > max_bits) count = max_bits;
  if (rtl) {
    x -= 3;
    dx = -(2 + padding);
  } else {
    x -= count * 3;
    dx = (2 + padding );
  }

  for (size_t i = 0; i < count; ++i, mask >>= 1, x += dx) {
    if (mask & 0x1)
      graphics.drawRect(x, y + 1, 2, height);
    else
      graphics.drawRect(x, y + height, 2, 1);
      
    if (clock_indicator == i)  
      graphics.drawRect(x, y + height + 2, 2, 2);
  }
}

inline static void DrawGateIndicator(weegfx::coord_t x, weegfx::coord_t y, uint8_t state) {
  state = (state + 3) >> 2;
  if (state)
    graphics.drawBitmap8(x, y, 4, TU::bitmap_gate_indicators_8 + (state << 2));
}

// Templated title bar that can have multiple columns
template <weegfx::coord_t start_x, int columns, weegfx::coord_t text_dx>
class TitleBar {
public:
  static constexpr weegfx::coord_t kColumnWidth = kDisplayWidth / columns;
  static constexpr weegfx::coord_t kTextX = text_dx;
  static constexpr weegfx::coord_t kTextY = 2;

  inline static void SetColumn(int column) {
    graphics.setPrintPos(start_x + kColumnWidth * column + kTextX, kTextY);
  }

  inline static void Draw() {
    graphics.drawHLine(start_x, kMenuLineH, kDisplayWidth - start_x);
    SetColumn(0);
  }

  inline static void Selected(int column) {
    graphics.invertRect(start_x + kColumnWidth * column, 0, kColumnWidth, kMenuLineH - 1);
  }

  inline static void DrawGateIndicator(int column, uint8_t state) {
    menu::DrawGateIndicator(start_x + kColumnWidth * column + 1, 2, state);
  }

  inline static weegfx::coord_t ColumnStartX(int column) {
    return start_x + kColumnWidth * column;
  }
};

// Common, default types
typedef TitleBar<kDefaultMenuStartX, 1, 2> DefaultTitleBar;
typedef TitleBar<kDefaultMenuStartX, 2, 2> DualTitleBar;
typedef TitleBar<kDefaultMenuStartX, 4, 6> QuadTitleBar;
typedef TitleBar<kDefaultMenuStartX, 6, 8> SixTitleBar;

// Essentially all TU apps are built around a list of settings; these two
// wrappers and the cursor wrapper replace the original macro-based drawing.
// start_x : Left edge of list (setting name column)
// value_x : Left edge of value column (edit cursor placed left of this)
// The value column is assumed to end at kDisplayWidth
//
struct SettingsListItem {
  bool selected, editing;
  weegfx::coord_t x, y;
  weegfx::coord_t valuex, endx;

  SettingsListItem() { }
  ~SettingsListItem() { }

  inline void DrawName(const settings::value_attr &attr) const {
    graphics.setPrintPos(x + kIndentDx, y + kTextDy);
    graphics.print(attr.name);
  }

  inline void DrawDefault(int value, const settings::value_attr &attr) const {
    DrawName(attr);

    graphics.setPrintPos(endx, y + kTextDy);
    if(attr.value_names)
      graphics.print_right(attr.value_names[value]);
    else
      graphics.pretty_print_right(value);

    if (editing)
      menu::DrawEditIcon(valuex, y, value, attr);
    if (selected)
      graphics.invertRect(x, y, kDisplayWidth - x, kMenuLineH - 1);
  }

  inline void DrawDefault(const char *str, int value, const settings::value_attr &attr) const {
    DrawName(attr);

    graphics.setPrintPos(endx, y + kTextDy);
    graphics.print_right(str);

    if (editing)
      menu::DrawEditIcon(valuex, y, value, attr);
    if (selected)
      graphics.invertRect(x, y, kDisplayWidth - x, kMenuLineH - 1);
  }

  inline void DrawValueMax(int value, const settings::value_attr &attr, int16_t _max) const {
    DrawName(attr);

    graphics.setPrintPos(endx, y + kTextDy);
    if(attr.value_names)
      graphics.print_right(attr.value_names[value]);
    else
      graphics.pretty_print_right(value);

    if (editing)
      menu::DrawEditIcon(valuex, y, value, attr.min_, _max);
    if (selected)
      graphics.invertRect(x, y, kDisplayWidth - x, kMenuLineH - 1);
  }
  
  template <bool editable>
  inline void DrawNoValue(int value, const settings::value_attr &attr) const {
    DrawName(attr);

    if (editable && editing)
      menu::DrawEditIcon(valuex, y, value, attr);
    if (selected)
      graphics.invertRect(x, y, kDisplayWidth - x, kMenuLineH - 1);
  }

  inline void DrawCustom() const {
    if (selected)
      graphics.invertRect(x, y, kDisplayWidth - x, kMenuLineH - 1);
  }

  inline void SetPrintPos() const {
    graphics.setPrintPos(x + kIndentDx, y + kTextDy);
  }

  DISALLOW_COPY_AND_ASSIGN(SettingsListItem);
};

template <int screen_lines, weegfx::coord_t start_x, weegfx::coord_t value_x, weegfx::coord_t end_x = kDefaultMenuEndX>
class SettingsList {
public:

  SettingsList(const ScreenCursor<screen_lines> &cursor)
  : cursor_(cursor)
  , current_item_(cursor.first_visible())
  , last_item_(cursor.last_visible())
  , y_(CalcLineY(kScreenLines - screen_lines))
  { }

  bool available() const {
    return current_item_ <= last_item_;
  }

  int Next(SettingsListItem &item) {
    item.selected = current_item_ == cursor_.cursor_pos();
    item.editing = item.selected && cursor_.editing();
    item.x = start_x;
    item.y = y_;
    item.valuex = value_x;
    item.endx = end_x;
    y_ += kMenuLineH;
    return current_item_++;
  }

  static void AbsoluteLine(int line, SettingsListItem &item) {
    item.x = start_x;
    item.y = CalcLineY(line);
    item.valuex = value_x;
    item.endx = end_x;
  }

private:
  const ScreenCursor<screen_lines> cursor_;
  int current_item_, last_item_;
  weegfx::coord_t y_;

  DISALLOW_COPY_AND_ASSIGN(SettingsList);
};

}; // namespace menu

}; // namespace TU

#endif // TU_MENUS_H
