mxmxmx/temps_utile-/soft/t_u_REV/TU_apps.h

// Copyright (c) 2016 Patrick Dowling
//
// Author: Patrick Dowling (pld@gurkenkiste.com)
//
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
#ifndef TU_APP_H_
#define TU_APP_H_

#include "TU_core.h"
#include "UI/ui_events.h"
#include "TU_app_storage.h"
#include "src/util_stream_buffer.h"

namespace TU {

enum AppEvent {
  APP_EVENT_SUSPEND,
  APP_EVENT_RESUME,
  APP_EVENT_SCREENSAVER_ON,
  APP_EVENT_SCREENSAVER_OFF
};

// This is a very poor-man's application "switching" framework, which has
// evolved out of the original (single-app) firmware.
//
// Using an interface class and virtual functions would probably provide a
// cleaner interface, but it's not worth bothering now.
//
// The additional call overhead of virtual functions can be avoided using a
// thunk table or other means, if it's in any way measurable. Only the ISR
// function is in a critical path anyway.
//
struct App {
  const uint16_t id;
  const uint16_t storage_version;
	const char *name;

  void (*Init)(); // one-time init
  size_t (*storageSize)(); // binary size of storage requirements
  size_t (*Save)(util::StreamBufferWriter &);
  size_t (*Restore)(util::StreamBufferReader &);
  void (*Reset)();

  void (*HandleAppEvent)(AppEvent); // Generic event handler

  void (*loop)(); // main loop function
  void (*DrawMenu)(); 
  void (*DrawScreensaver)();

  void (*HandleButtonEvent)(const UI::Event &);
  void (*HandleEncoderEvent)(const UI::Event &);
  void (*isr)();
};

using AppHandle = const App *;

#define DECLARE_APP_INTERFACE(prefix) \
  extern void prefix ## _init(); \
  extern size_t prefix ## _storageSize(); \
  extern size_t prefix ## _save(util::StreamBufferWriter &); \
  extern size_t prefix ## _restore(util::StreamBufferReader &); \
  extern void prefix ## _reset(); \
  extern void prefix ## _handleAppEvent(TU::AppEvent); \
  extern void prefix ## _loop(); \
  extern void prefix ## _menu(); \
  extern void prefix ## _screensaver(); \
  extern void prefix ## _handleButtonEvent(const UI::Event &); \
  extern void prefix ## _handleEncoderEvent(const UI::Event &); \
  extern void prefix ## _isr(); \

#define INSTANTIATE_APP(id, version, name, prefix) \
{ TWOCCS(id), \
  version, \
  name, \
  prefix ## _init, prefix ## _storageSize, prefix ## _save, prefix ## _restore, \
  prefix ## _reset, \
  prefix ## _handleAppEvent, \
  prefix ## _loop, prefix ## _menu, prefix ## _screensaver, \
  prefix ## _handleButtonEvent, \
  prefix ## _handleEncoderEvent, \
  prefix ## _isr \
}

class AppSwitcher {
public:

  void Init(bool reset_settings);

  inline void ISR() __attribute__((always_inline)) {
    if (current_app_ && current_app_->isr)
      current_app_->isr();
  }

  AppHandle find(uint16_t id) const;

  size_t num_available_apps() const;
  AppHandle app_desc(size_t index) const;

  uint16_t current_app_id() const;

  size_t last_slot_index() const;

  AppHandle current_app() const {
    return current_app_;
  }

  bool SaveCurrentAppToSlot(size_t slot_index);
  bool LoadAppFromSlot(size_t slot_index, bool save_state);
  bool LoadAppFromDefaults(size_t app_index);
  void SwitchToApp(size_t app_index);

private:
  AppHandle current_app_;

  int index_of(uint16_t id) const;

  void set_current_app(size_t index);
  void set_current_app(AppHandle app);
};

extern AppSwitcher app_switcher;

}; // namespace TU

#endif // TU_APP_H_
