mxmxmx/temps_utile-/soft/t_u_REV/TU_options.h

#ifndef TU_OPTIONS_H_
#define TU_OPTIONS_H_
//
// options ... 
//
/* ------------ DAC offset modification (use 10k) -----------------------------  */
//#define MOD_OFFSET
/* ------------ uncomment if using a pre-rev 1 PCB ----------------------------  */
//#define _TEMPS_UTILE_REV_0
/* ------------ Northern Light 4U Model 2TT -----------------------------------  */
//#define MODEL_2TT

#endif
