mxmxmx/temps_utile-/soft/t_u_REV/TU_outputs.cpp

#include <spififo.h>
#include "TU_outputs.h"
#include "TU_gpio.h"

namespace TU {

/*static*/
void OUTPUTS::Init(CalibrationData *calibration_data) {

  pinMode(CLK1, TU_GPIO_OUTPUTS_PINMODE);
  pinMode(CLK2, TU_GPIO_OUTPUTS_PINMODE);
  pinMode(CLK3, TU_GPIO_OUTPUTS_PINMODE);
  // CLK4 == DAC
  pinMode(CLK5, TU_GPIO_OUTPUTS_PINMODE);
  pinMode(CLK6, TU_GPIO_OUTPUTS_PINMODE);

  calibration_data_ = calibration_data;
  history_tail_ = 0;
  memset(history_, 0, sizeof(uint16_t) * kHistoryDepth * NUM_CHANNELS);
}

void OUTPUTS::SPI_Init() {

  uint32_t ctar0, ctar1;

  SIM_SCGC6 |= SIM_SCGC6_SPI0;
  CORE_PIN11_CONFIG = PORT_PCR_DSE | PORT_PCR_MUX(2);
  CORE_PIN14_CONFIG = PORT_PCR_DSE | PORT_PCR_MUX(2);
  
  ctar0 = SPI_CTAR_DBR; // default
  #if   F_BUS == 60000000
      ctar0 = (SPI_CTAR_PBR(0) | SPI_CTAR_BR(0) | SPI_CTAR_DBR); //(60 / 2) * ((1+1)/2) = 30 MHz
  #elif F_BUS == 48000000
      ctar0 = (SPI_CTAR_PBR(0) | SPI_CTAR_BR(0) | SPI_CTAR_DBR); //(48 / 2) * ((1+1)/2) = 24 MHz          
  #endif
  ctar1 = ctar0;
  ctar0 |= SPI_CTAR_FMSZ(7);
  ctar1 |= SPI_CTAR_FMSZ(15);
  SPI0_MCR = SPI_MCR_MSTR | SPI_MCR_PCSIS(0x1F);
  SPI0_MCR |= SPI_MCR_CLR_RXF | SPI_MCR_CLR_TXF;

  // update ctars
  uint32_t mcr = SPI0_MCR;
  if (mcr & SPI_MCR_MDIS) {
    SPI0_CTAR0 = ctar0;
    SPI0_CTAR1 = ctar1;
  } else {
    SPI0_MCR = mcr | SPI_MCR_MDIS | SPI_MCR_HALT;
    SPI0_CTAR0 = ctar0;
    SPI0_CTAR1 = ctar1;
    SPI0_MCR = mcr;
  }
}


/*static*/
OUTPUTS::CalibrationData *OUTPUTS::calibration_data_ = nullptr;
/*static*/
uint32_t OUTPUTS::values_[CLOCK_CHANNEL_LAST];
/*static*/
uint32_t OUTPUTS::states_[CLOCK_CHANNEL_LAST];
/*static*/
uint16_t OUTPUTS::history_[NUM_CHANNELS][OUTPUTS::kHistoryDepth];
/*static*/ 
volatile size_t OUTPUTS::history_tail_;
/*static*/
uint16_t OUTPUTS::calibrated_v_oct_;

}; // namespace TU

const uint16_t _MAX_VALUE = 4095;
const int8_t _DAC_CHANNEL = CLOCK_CHANNEL_4;

void set_Output1(uint8_t data) {
  digitalWriteFast(CLK1, data);
}

void set_Output2(uint8_t data) {
  digitalWriteFast(CLK2, data);
}

void set_Output3(uint8_t data) {
  digitalWriteFast(CLK3, data);
}

void set_Output4(uint16_t data) {

  uint16_t _data = data > _MAX_VALUE ? _MAX_VALUE : data;
  #if defined(__MK20DX256__)
    SIM_SCGC2 |= SIM_SCGC2_DAC0;
    DAC0_C0 = DAC_C0_DACEN | DAC_C0_DACRFS; // 3.3V VDDA = DACREF_2
    *(int16_t *)&(DAC0_DAT0L) = _data;
  #endif
}

void set_Output5(uint8_t data) {
  digitalWriteFast(CLK5, data);
}

void set_Output6(uint8_t data) {
  digitalWriteFast(CLK6, data);
}
