mxmxmx/temps_utile-/soft/t_u_REV/TU_BPM.h

#ifndef TU_BPM_H_
#define TU_BPM_H_

 /*
 *
 *  BPM (1-255), quarter notes in ticks. 1 tick = 60us : 
 *  float bpm_exact = 1000000/(float)bpm; 
 *  uint32_t bpm_tick = (uint32_t)(bpm_exact = + 0.5f);
 *
*/

const uint32_t BPM_microseconds_4th[ ] = { 

	1000000, // 1BPM 
	500000,
	333333,
	250000,
	200000,
	166667,
	142857,
	125000,
	111111,
	100000,
	90909,
	83333,
	76923,
	71429,
	66667,
	62500,
	58824,
	55556,
	52632,
	50000,
	47619,
	45455,
	43478,
	41667,
	40000,
	38462,
	37037,
	35714,
	34483,
	33333,
	32258,
	31250,
	30303,
	29412,
	28571,
	27778,
	27027,
	26316,
	25641,
	25000,
	24390,
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
	3922, // 255 BPM
  3906,
  3891,
  3876,
  3861,
  3846,
  3831,
  3817,
  3802,
  3788,
  3774,
  3759,
  3745,
  3731,
  3717,
  3704,
  3690,
  3676,
  3663,
  3650,
  3636,
  3623,
  3610,
  3597,
  3584,
  3571,
  3559,
  3546,
  3534,
  3521,
  3509,
  3497,
  3484,
  3472,
  3460,
  3448,
  3436,
  3425,
  3413,
  3401,
  3390,
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
};

#endif // TU_BPM
