mxmxmx/temps_utile-/(commit log)

2014-09-25 BOM / temps utile
    BOM
2014-09-28 BOM
    updated
2015-11-17 Fix error compiling with Arduino 1.6.6
2016-05-08 o_c framework test
2016-05-08 calibration menu
2016-05-16 add version switch
2016-05-16 tact switches
    disabled inverted setting; pattern display
    [APP_CLK.ino, TU_strings.cpp]
2016-05-16 dac calibration
2016-05-16 save calibration data
2016-05-28 gerbers (1b)
2016-05-29 Revert "sync"
    This reverts commit 2aec328494a47d25e5ec39be70cfaefe48596d77.
    [APP_CLK.ino]
2016-05-30 clk_cnt / quick fix
    [APP_CLK.ino]
2016-06-18 clock jitter
2016-08-24 fix min BPM value
    [APP_CLK.ino]
2016-08-26 reset ticks, internal timer
    [APP_CLK.ino]
2016-08-28 reset to defaults, left; click edit
    [APP_CLK.ino]
2016-09-03 BOM, complete
2016-09-14 fix 1.6.11 linker error
    [APP_CLK.ino, SH1106_128x64_driver.cpp, TU_apps.h, TU_calibration.h, TU_core.h, TU_debug.cpp, TU_menus.h, TU_strings.cpp]
2016-11-05 1c
    enlarge encoder holes
2016-11-26 fix display when MULT > 1
    [APP_CLK.ino]
2016-12-22 [BOM] 470n
2016-12-24 [BOM] 10uF
2016-12-24 [BOM] 1uF, 470n
2017-01-03 start up / swap
    [t_u_REV.ino]
2017-01-13 add some multiplier, note that stored multipliers for older firmware will be wrong (offset by two)
    [APP_CLK.ino]
2017-01-16 ensure that internal frequency is only set in one thread, avoid sync issues when changing dynamically
    [APP_CLK.ino]
2017-01-16 fix off-by-one error when determining if the internal clock is 'triggered'
    [APP_CLK.ino]
2017-01-16 fix final case in 'hack' to include x1
    [APP_CLK.ino]
2017-01-17 some changes to avoid channels from losing sync when using the internal clock and changing the tempo rapidly. there are still some double-triggers when slowing the tempo down.
    [APP_CLK.ino]
2017-01-20 fixes to sync with external clock source
    [APP_CLK.ino]
2017-01-21 revert to 28daebd93377a513909aedc7c4bb298f2b503bf4 to try a different approach
    [APP_CLK.ino]
2017-01-21 add some multipliers, note that stored multipliers for older firmware will be wrong (offset by two)
    [APP_CLK.ino]
2017-04-10 [1.36] [fix] integrate ADC.h
    [TU_ADC.h, t_u_REV.ino]
2017-06-30 [TU] encoder direction
2017-07-01 [TU] case
2017-07-27 [CLK] reset channel F
    [APP_CLK.ino]
2017-07-27 [CLK] reset use channel_f
    [APP_CLK.ino]
2017-07-27 [TU] fix init / version
    [APP_CLK.ino, TU_digital_inputs.cpp, TU_digital_inputs.h, t_u_REV.ino]
2017-07-28 [CLK] "still und leise" ?
2017-07-28 [CLK] fix euclidian offset
    [APP_CLK.ino]
2018-01-26 improve RST behavior (only reset the div count if the channel is triggered)
    [APP_CLK.ino]
2018-02-22 [2TT] ADC offset
2018-03-02 [ARP] fix button / menu
    [APP_CLK.ino]
2018-11-09 Add NOP storage type that doesn't get saved/loaded
    [APP_CLK.ino]
2018-11-09 Fix cursor/scrolling for < 4 visible items
    [TU_menus.h]
2018-11-09 Very rough app menu supporting load/save slots
2018-11-09 Remove 'old' storage mechanism, prep for slots
2018-11-09 Cleanup, debug view of slots, initial save implementation
2018-11-09 Add indication when slot armed
2018-11-09 Refactor/rename app switching interface
2018-11-09 Add app switching path without reset (i.e. just switch to current state, exit menu)
    [TU_app_menu.cpp, TU_app_menu.h, TU_apps.cpp, TU_apps.h, TU_global_config.cpp]
2018-11-09 Set cursors in app menu to last used slot at startup
2019-01-23 [ADC] use DMA
2019-01-23 [BURST] phase fix
    --> internal clock
    [APP_CLK.ino]
2019-01-25 [USER SLOTS] disable debug
2019-01-25 [USER SLOTS] cursor
